GauriK58/PPG-Heart-Rate-Monitor/images/comp_sim.png

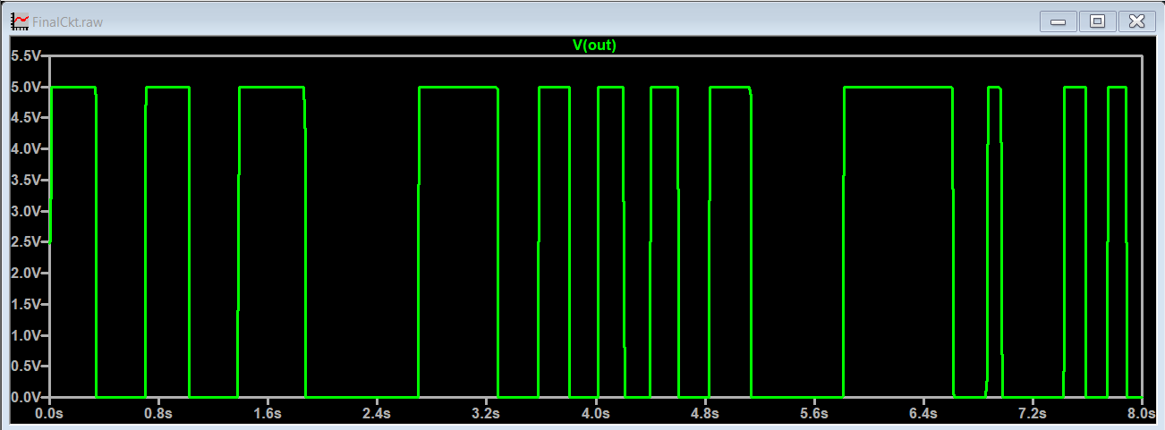
images/comp_sim.png
