GauriK58/PPG-Heart-Rate-Monitor/images/Final_HW_ckt.jpeg

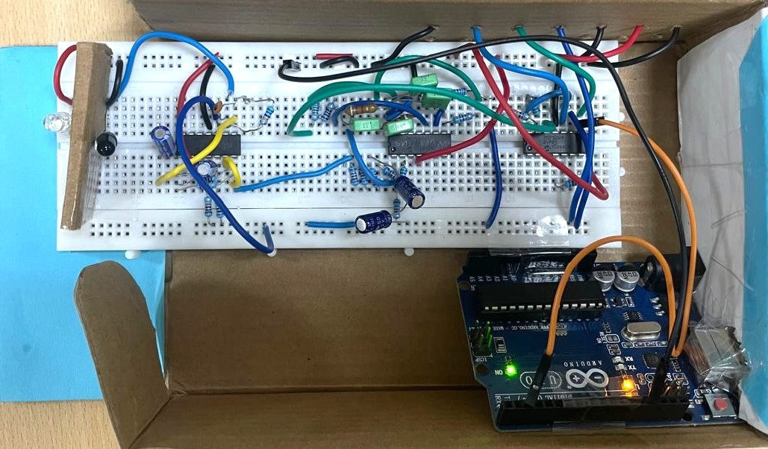
images/Final_HW_ckt.jpeg
