GauriK58/PPG-Heart-Rate-Monitor/images/final_sim.png

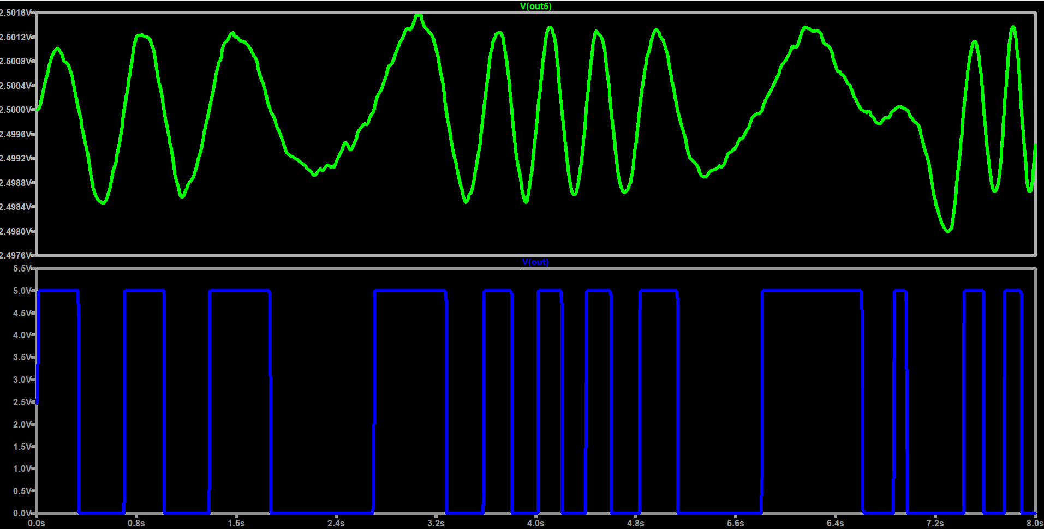
images/final_sim.png
