GauriK58/PPG-Heart-Rate-Monitor/images/fullckt.png

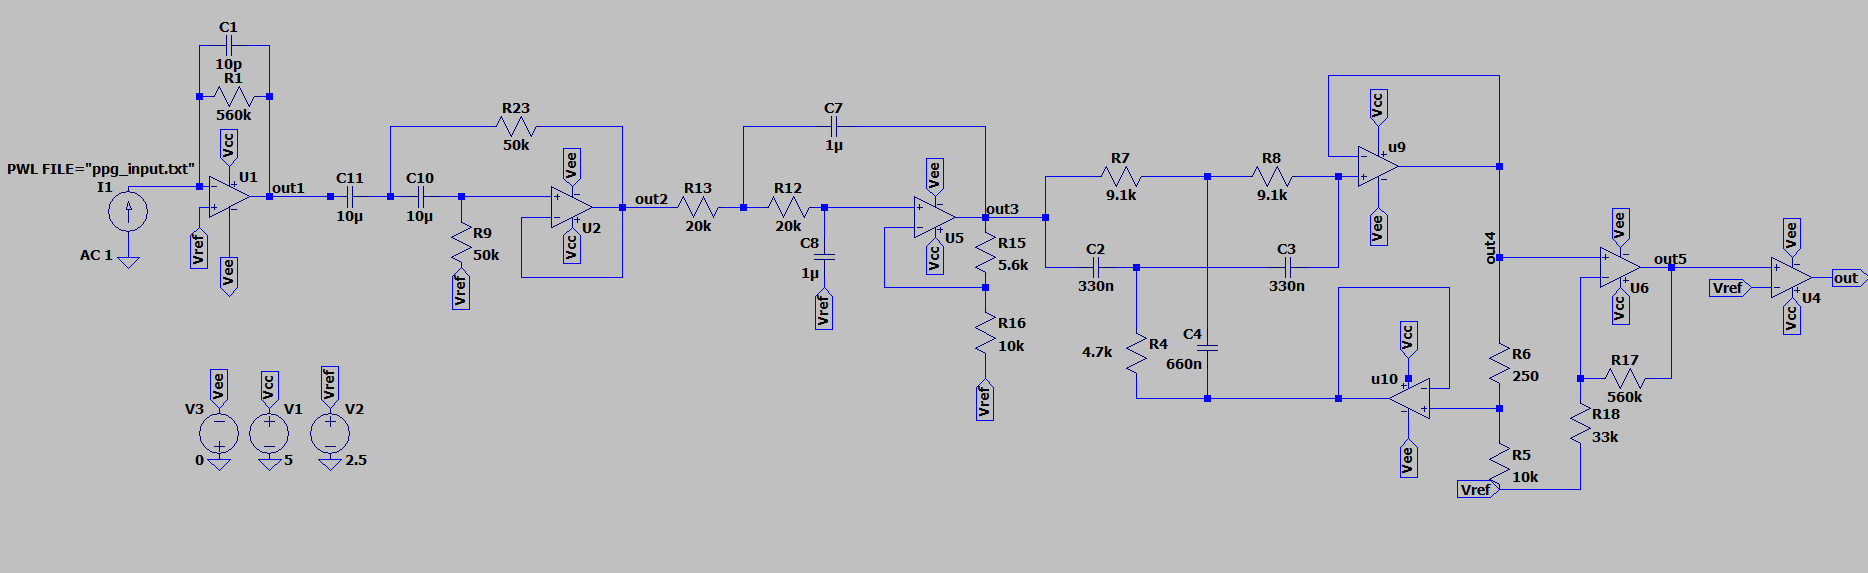
images/fullckt.png
