GauriK58/PPG-Heart-Rate-Monitor/images/gain_ckt.png

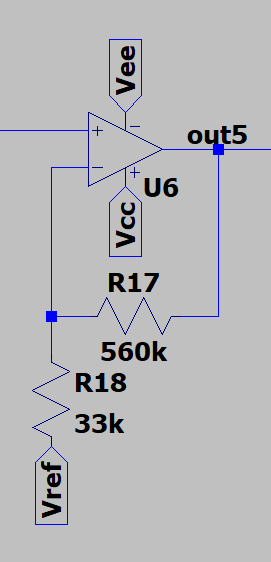
images/gain_ckt.png
