GauriK58/PPG-Heart-Rate-Monitor/images/gain_sim.png

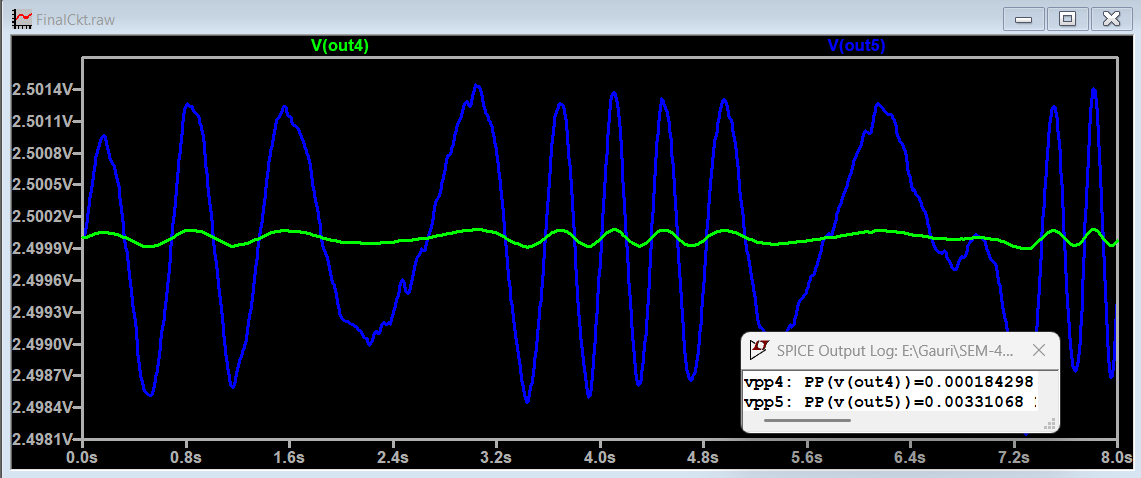
images/gain_sim.png
