GauriK58/PPG-Heart-Rate-Monitor/images/highpass_ckt.png

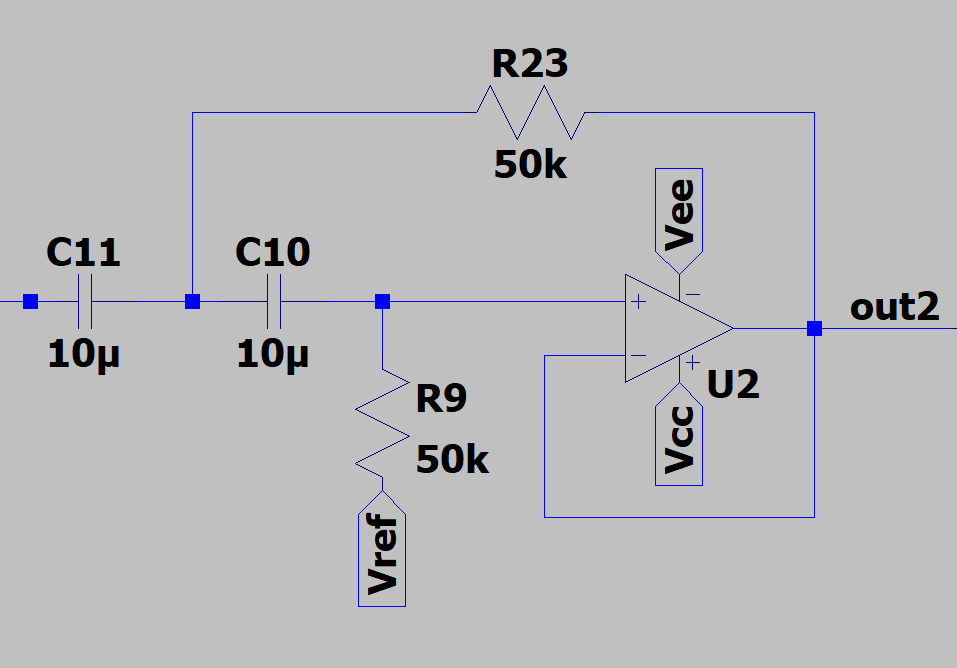
images/highpass_ckt.png
