GauriK58/PPG-Heart-Rate-Monitor/images/HP_bode.png

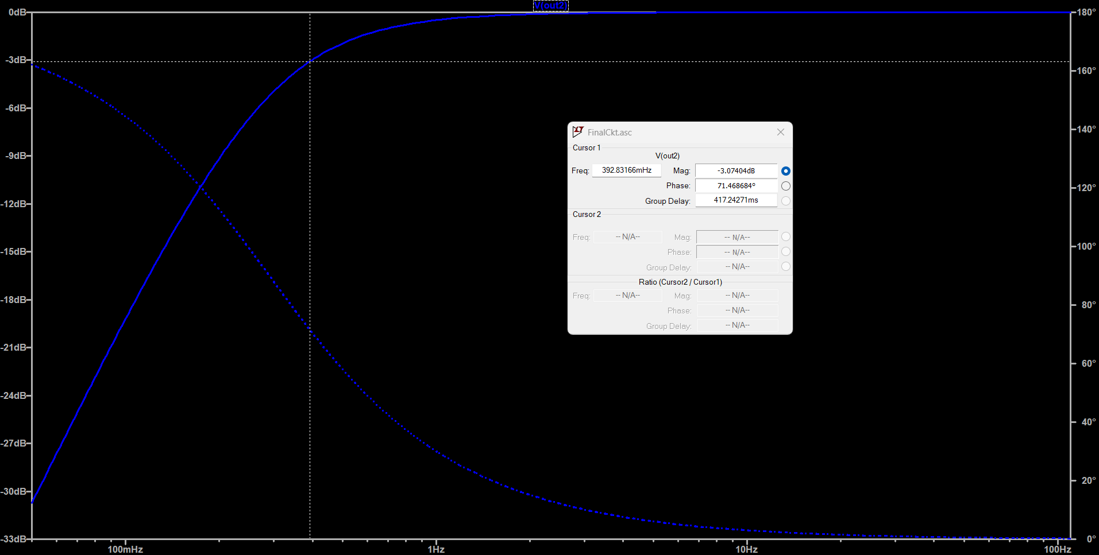
images/HP_bode.png
