GauriK58/PPG-Heart-Rate-Monitor/images/hp_gain_bode.png

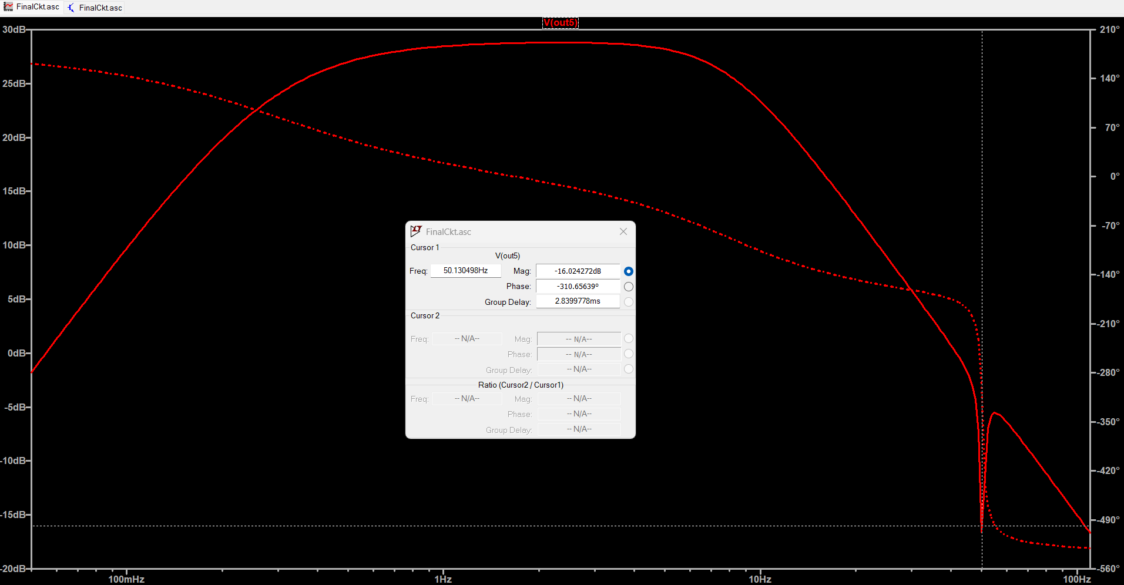
images/hp_gain_bode.png
