GauriK58/PPG-Heart-Rate-Monitor/images/HP_LP_bode.png

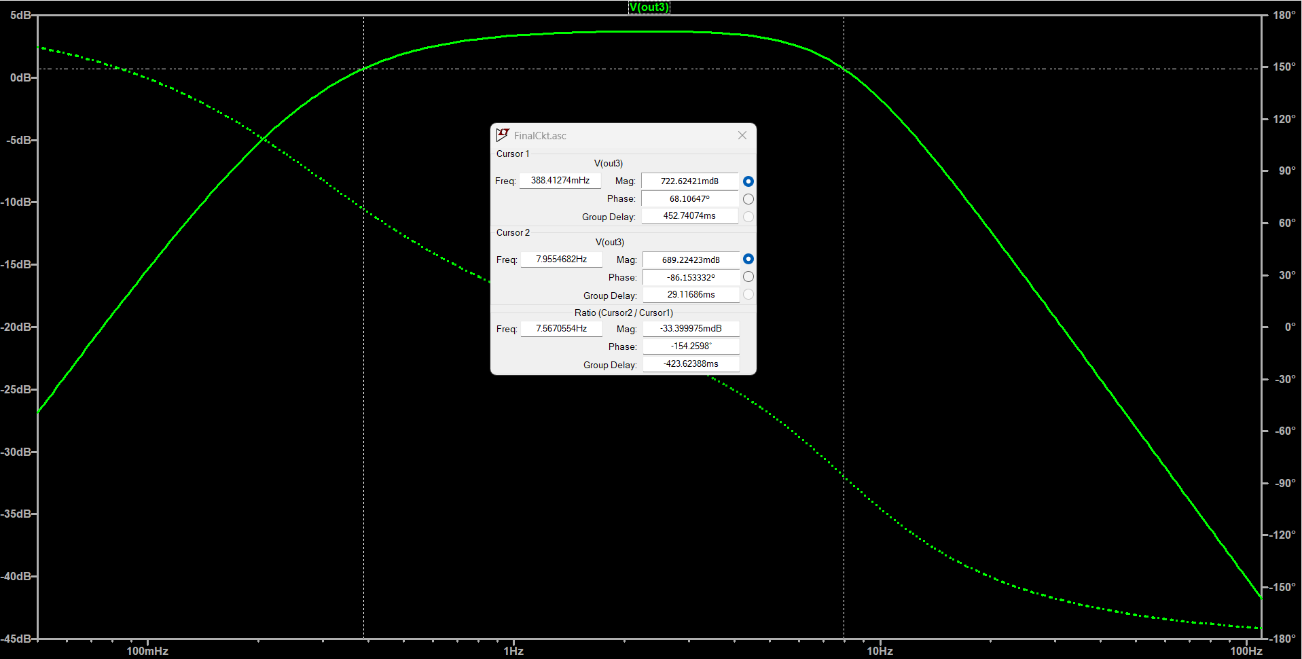
images/HP_LP_bode.png
