GauriK58/PPG-Heart-Rate-Monitor/images/hp_notch_bode.png

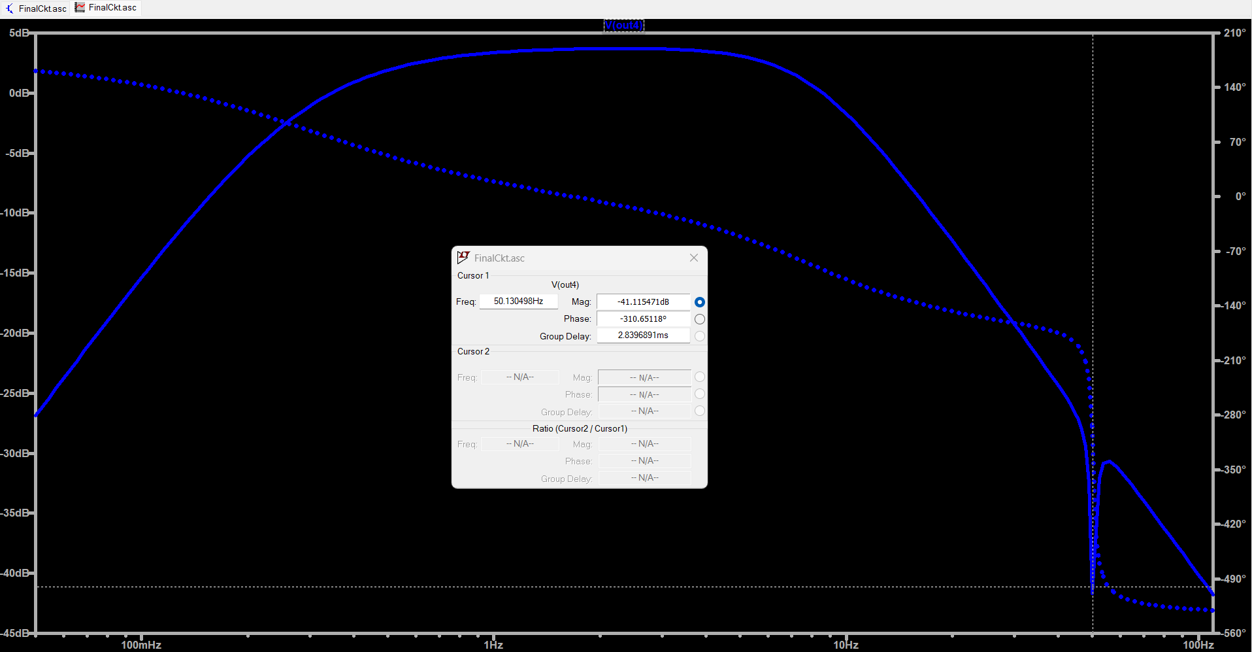
images/hp_notch_bode.png
