GauriK58/PPG-Heart-Rate-Monitor/images/HP_sim.png

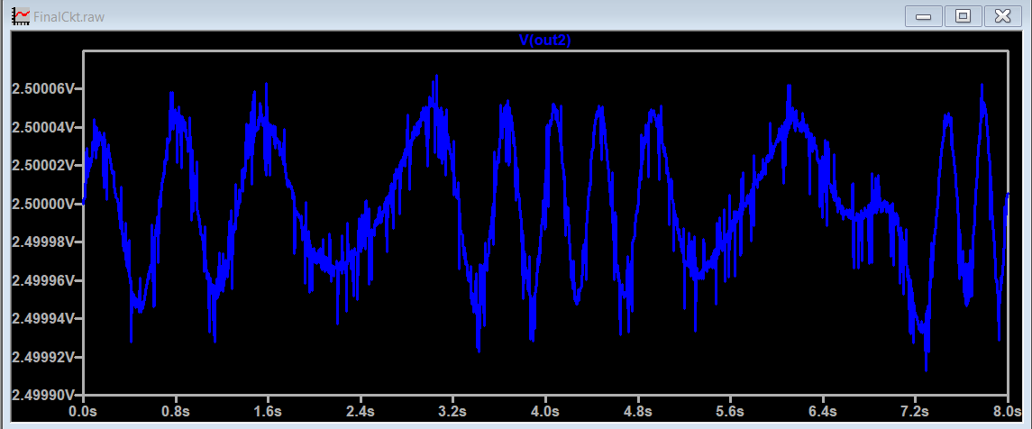
images/HP_sim.png
