GauriK58/PPG-Heart-Rate-Monitor/images/HP_to_notch_HW.jpeg

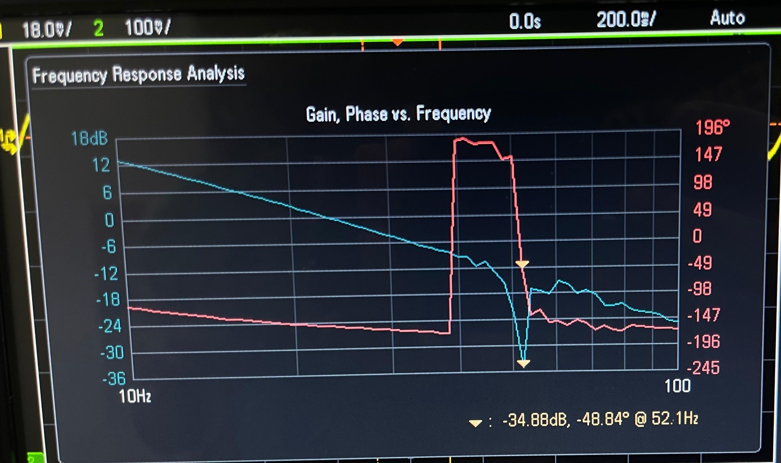
images/HP_to_notch_HW.jpeg
