GauriK58/PPG-Heart-Rate-Monitor/images/lowpass_ckt.png

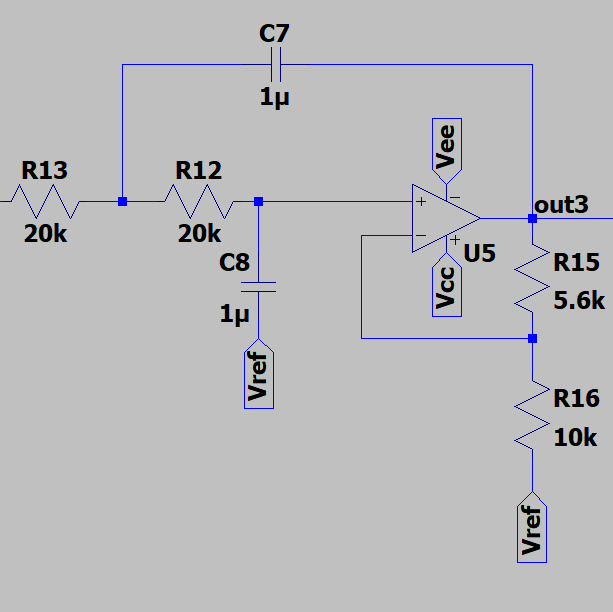
images/lowpass_ckt.png
