GauriK58/PPG-Heart-Rate-Monitor/images/LP_bode.png

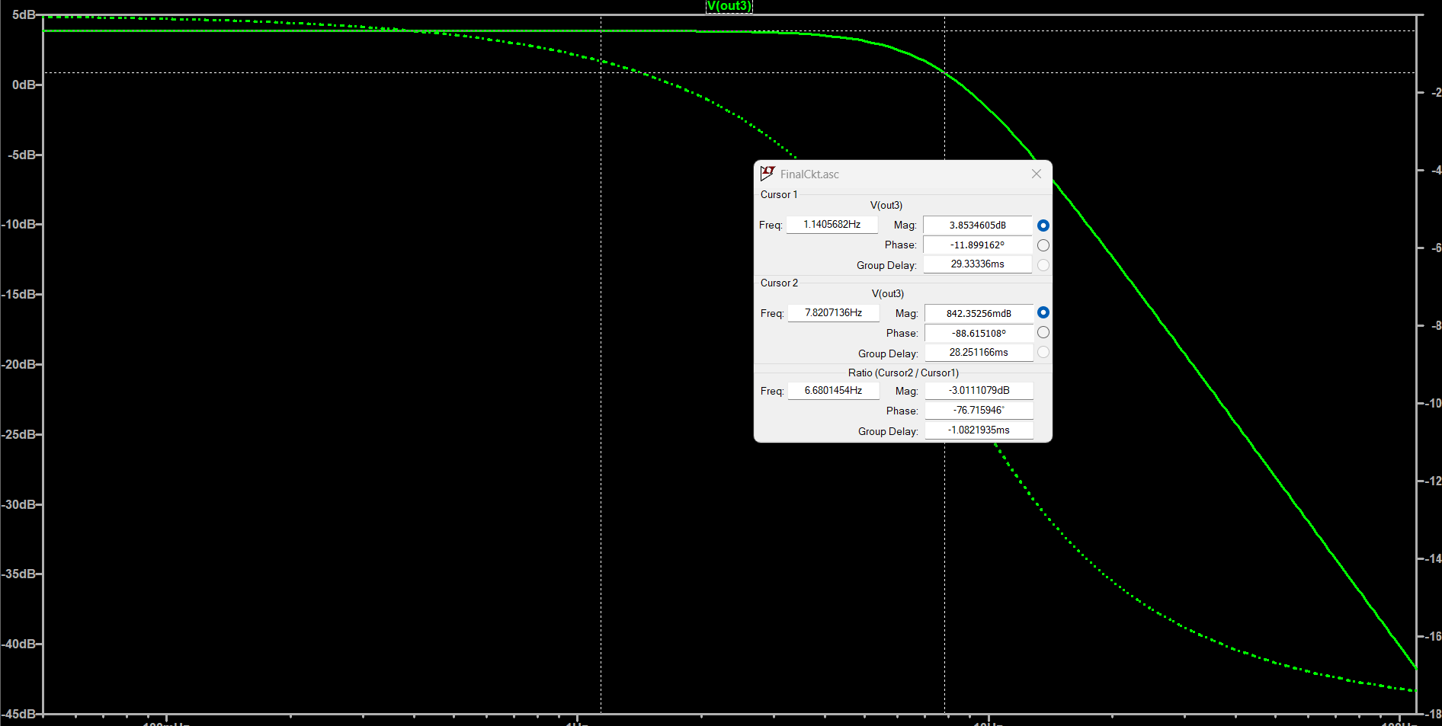
images/LP_bode.png
