GauriK58/PPG-Heart-Rate-Monitor/images/LP_sim.png

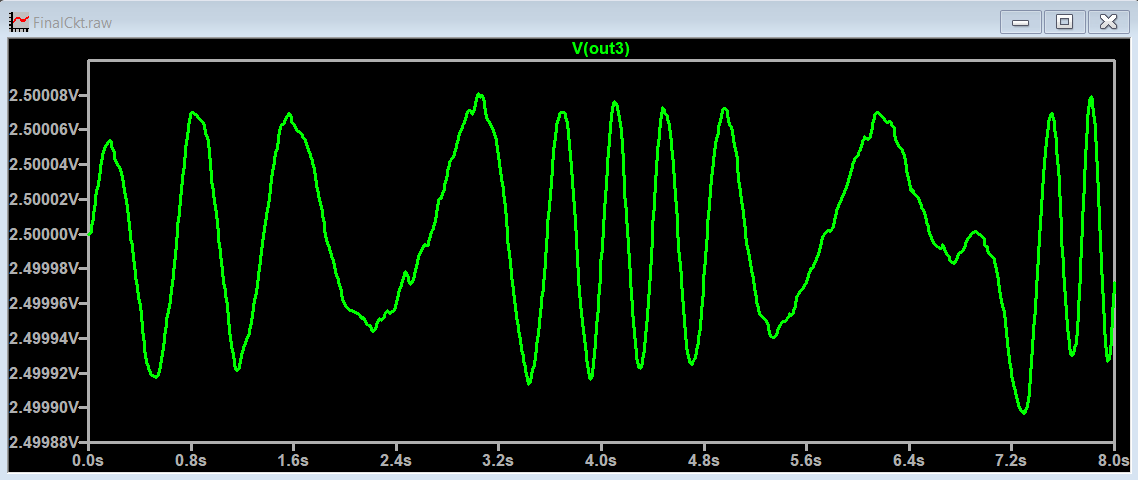
images/LP_sim.png
