GauriK58/PPG-Heart-Rate-Monitor/images/notch)ckt.png

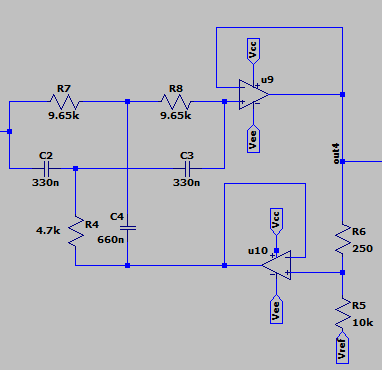
images/notch)ckt.png
