GauriK58/PPG-Heart-Rate-Monitor/images/notch_bode.png

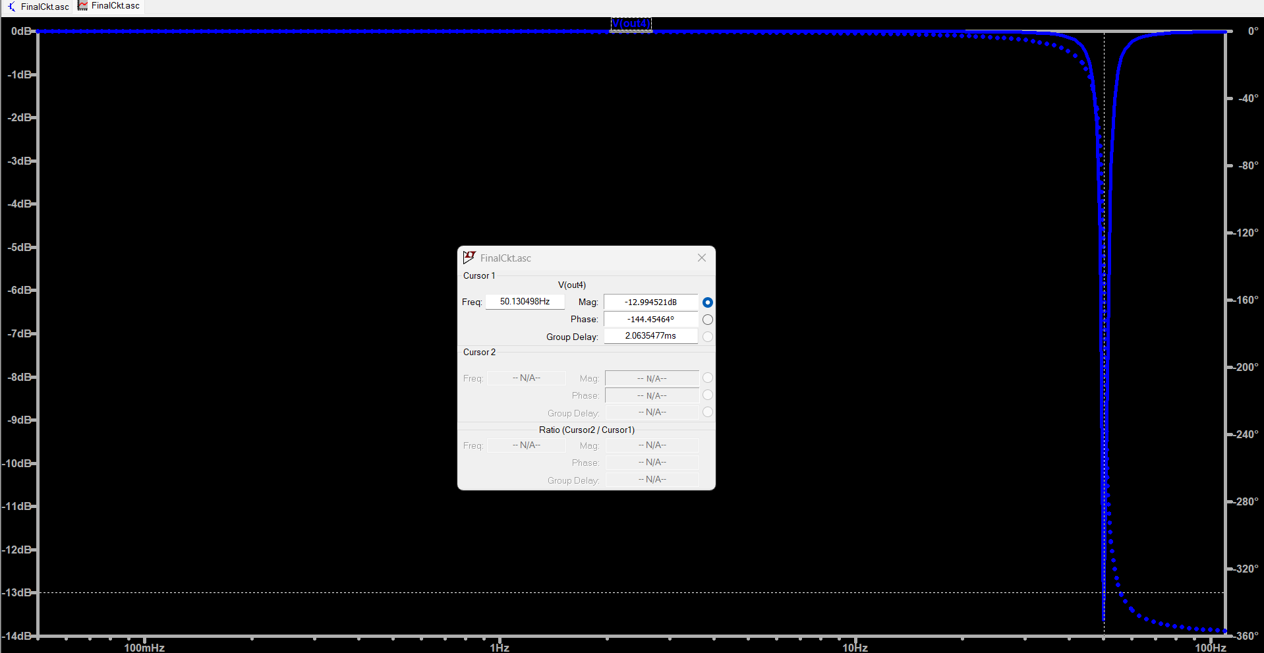
images/notch_bode.png
