GauriK58/PPG-Heart-Rate-Monitor/images/notch_only_bode.png

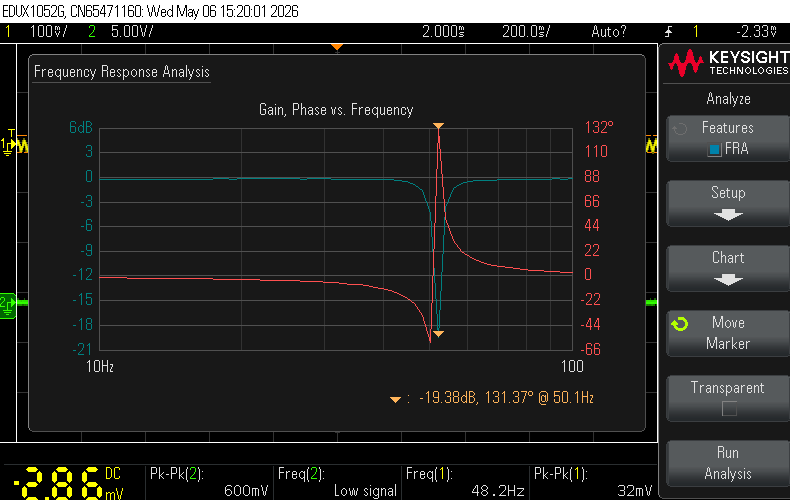
images/notch_only_bode.png
