GauriK58/PPG-Heart-Rate-Monitor/images/Notch_sim.png

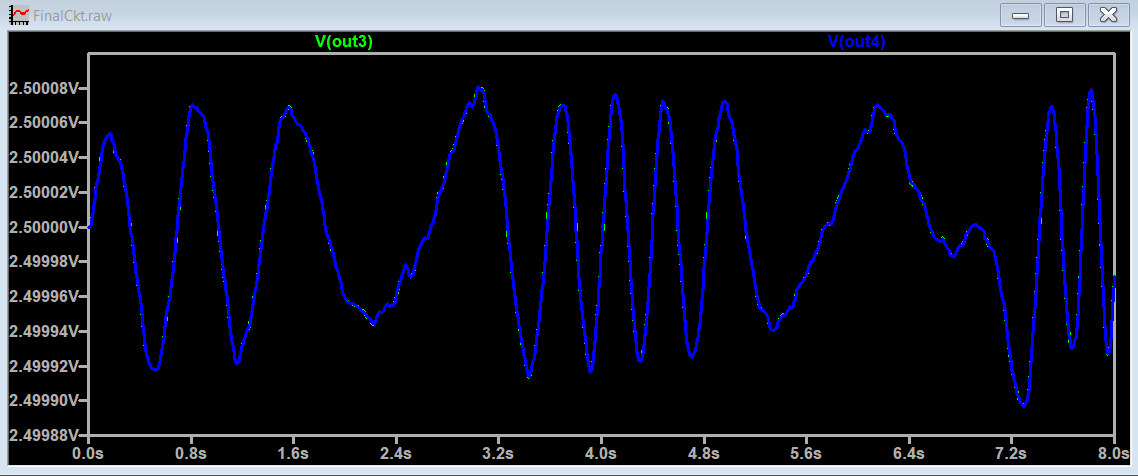
images/Notch_sim.png
