GauriK58/PPG-Heart-Rate-Monitor/images/TIA_ckt.png

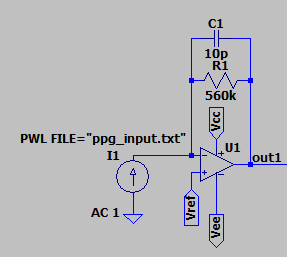
images/TIA_ckt.png
