GauriK58/PPG-Heart-Rate-Monitor/images/TIA_sim.png

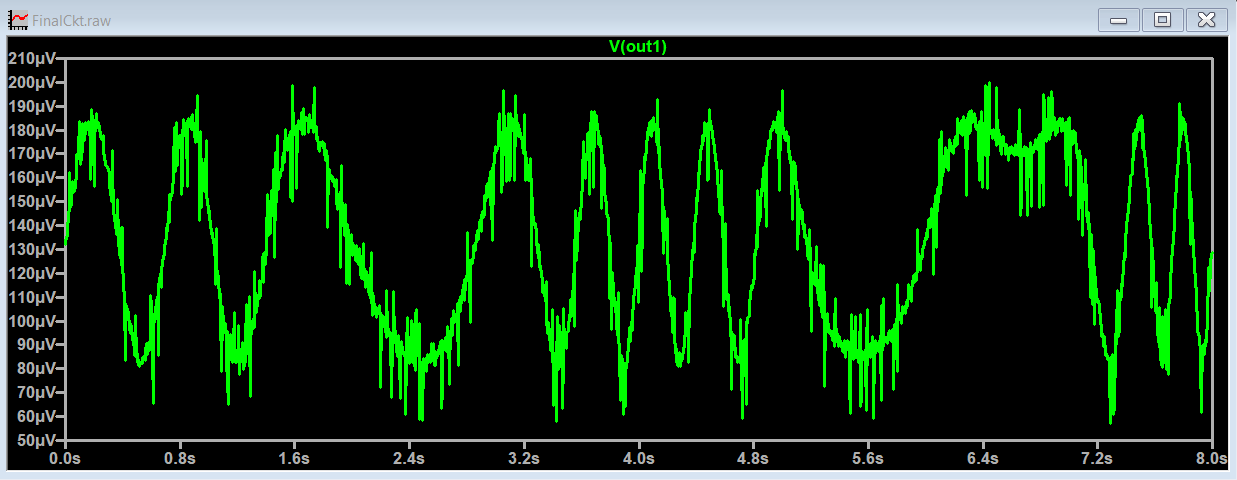
images/TIA_sim.png
