GauriK58/PPG-Heart-Rate-Monitor/LTSpice files/Ckt.asc

C1: cap; 10p
C2: cap; 1µ
C3: cap; 2µ
C4: cap; 1µ
C5: cap; 2µ
C8: cap; 0.1µ
C9: cap; 0.1µ
C10: cap; 0.2µ
I1: current; PWL FILE="ppg_input.txt"
R1: res; 560k
R2: res; 20k
R3: res; 560k
R4: res; 220k
R5: res; 10k
R6: res; 10k
R7: res; 220k
R8: res; 10k
R9: res; 10k
R10: res; 5.6k
R11: res; 560k
R12: res; 560k
R13: res; 10k
R15: res; 560k
R19: res; 20k
R20: res; 16k
R21: res; 10k
R22: res; 250
R23: res; 32k
R24: res; 32k
U1: UniversalOpAmp2
U2: UniversalOpAmp2
U4: UniversalOpAmp2
U7: UniversalOpAmp2
U8: UniversalOpAmp2
U9: UniversalOpAmp2
U10: UniversalOpAmp2
V1: voltage; 5
V2: voltage; 2.5
V3: voltage; 0
Named nets: 0, Vcc, Vee, out1, out3, out4, out2, Vref, out5, out6
.include UA741.301
.tran 8
.include TSMC_180nm.txt
.ac dec 100 0.05 110
.meas tran Vpp1 pp V(out1)
.meas tran Vpp2 pp V(out2)
.meas tran Vpp3 pp V(out3)
.meas tran Vpp4 pp V(out4)
.meas tran Vpp5 pp V(out5)
.meas tran Vpp6 pp V(out6)
.meas tran Tall TRIG V(out6) VAL=2.5 RISE=2 TARG V(out6) VAL=2.5 RISE=9
 
.meas tran Tper param Tall/7
 
.meas tran BPM param 60/Tper
