GauriK58/PPG-Heart-Rate-Monitor/LTSpice files/FinalCkt.asc

C1: cap; 10p
C2: cap; 330n
C3: cap; 330n
C4: cap; 660n
C7: cap; 1µ
C8: cap; 1µ
C10: cap; 10µ
C11: cap; 10µ
I1: current; PWL FILE="ppg_input.txt"; AC 1
R1: res; 560k
R4: res; 4.7k
R5: res; 10k
R6: res; 250
R7: res; 9.65k
R8: res; 9.65k
R9: res; 50k
R12: res; 20k
R13: res; 20k
R15: res; 5.6k
R16: res; 10k
R17: res; 560k
R18: res; 33k
R23: res; 50k
U1: UniversalOpAmp2
U2: UniversalOpAmp2
U4: UniversalOpAmp2
U5: UniversalOpAmp2
U6: UniversalOpAmp2
u9: UniversalOpAmp2
u10: UniversalOpAmp2
V1: voltage; 5
V2: voltage; 2.5
V3: voltage; 0
Named nets: 0, Vcc, Vee, out1, out4, Vref, out5, out3, out, out2
.include UA741.301
.tran 8
.include TSMC_180nm.txt
.ac dec 100 0.05 110
.meas tran Vpp1 pp V(out1)
.meas tran Vpp2 pp V(out2)
.meas tran Vpp3 pp V(out3)
.meas tran Vpp4 pp V(out4)
.meas tran Vpp5 pp V(out5)
.meas tran Vpp6 pp V(out6)
.meas tran Tall TRIG V(out6) VAL=2.5 RISE=2 TARG V(out6) VAL=2.5 RISE=9
 
.meas tran Tper param Tall/7
 
.meas tran BPM param 60/Tper
