GauriK58/PPG-Heart-Rate-Monitor/LTSpice files/Notch 2 amps.asc

C1: cap; 0.1µ
C2: cap; 0.1µ
C3: cap; 0.2µ
R1: res; 13.5k
R2: res; 27k
R3: res; 27k
R4: res; 250
R5: res; 10k
U1: UA741
U2: UA741
V1: voltage; ""; AC 1
V2: voltage; 12
V3: voltage; 12
V4: voltage; -12
V5: voltage; -12
Named nets: 0
.ac dec 100 1 1k
.include ua741.301
